DannyGH/Spectacle_Accelerometer_Input_Board/Hardware/Spectacle_Accelerometer_Input_Board.brd

## EAGLE design Hardware/Spectacle_Accelerometer_Input_Board.brd (2017-01-25)

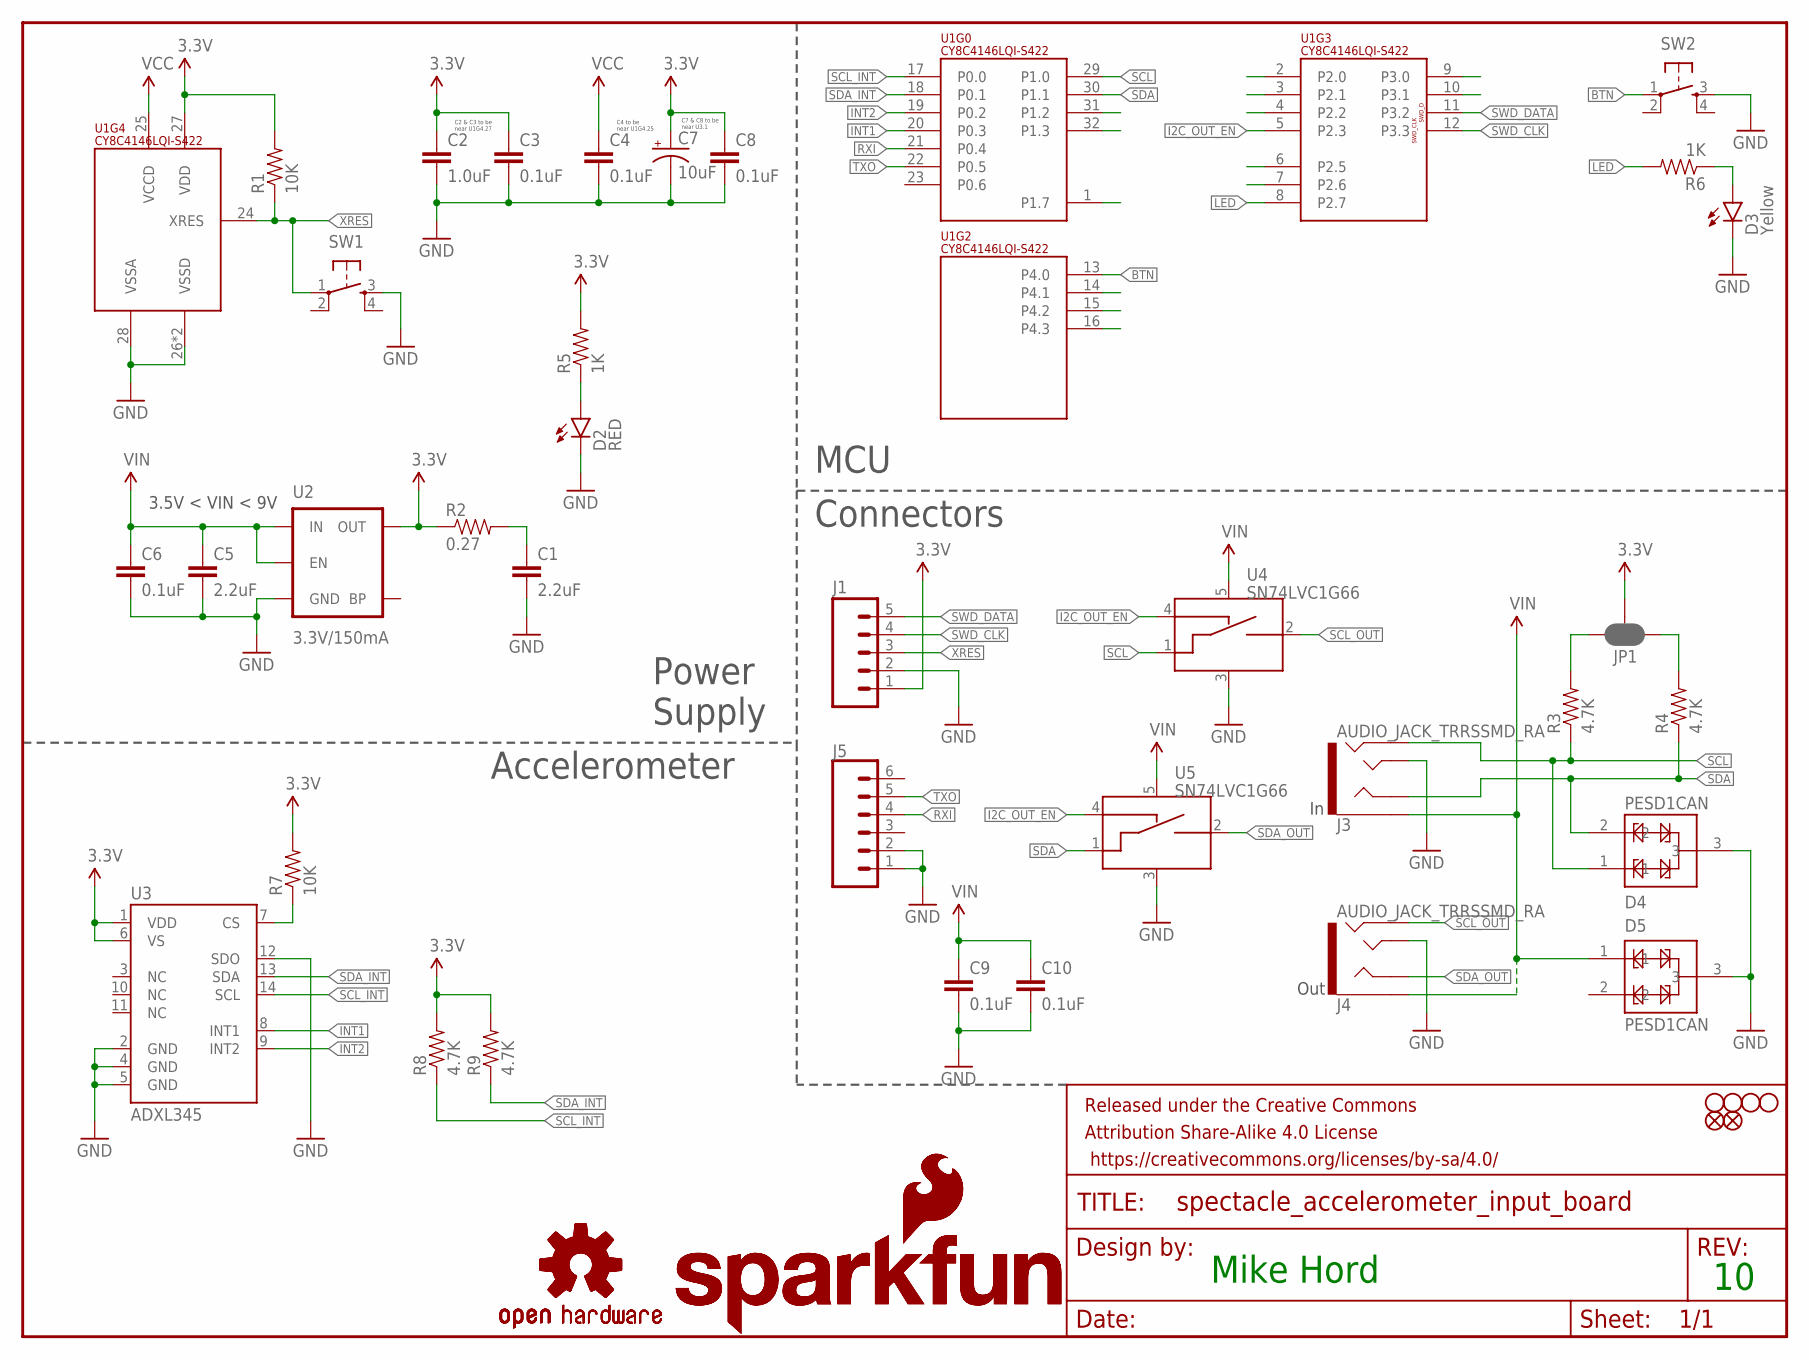
[picture p1: schematic Spectacle_Accelerometer_Input_Board.sch]

Parts:
C1, C5: 2.2uF; 0603-CAP
C2: 1.0uF; 0402-CAP
C3, C4, C6, C8, C9, C10: 0.1uF; 0402-CAP
C7: 10uF; EIA3216
D2: RED; LED-0603
D3: Yellow; LED-0603
D4, D5: PESD1CAN; SOT23-3
FD1, FD2: FIDUCIALUFIDUCIAL; MICRO-FIDUCIAL
FRAME1: FRAME-LETTER; CREATIVE_COMMONS
H1, H2, H3, H4: STAND-OFF
J1: M05NO_SILK; 1X05_NO_SILK
J3, J4: AUDIO_JACK_TRRSSMD_RA; AUDIO_JACK_3.5MM_TRRS_SMD_RA
J5: CONN_06NO_SILK_NO_POP; 1X06_NO_SILK
JP1: JUMPER-PAD-3-NC_BY_PASTE; PAD-JUMPER-3-NC_BY_PASTE_YES_SILK_FULL_BOX
LOGO1, LOGO4: SFE_LOGO_NAME_FLAME.1_INCH; SFE_LOGO_NAME_FLAME_.1
LOGO2, LOGO3: OSHW-LOGOS; OSHW-LOGO-S
R1, R7: 10K; 0603-RES
R2: 0.27; 0603-RES
R3, R4, R8, R9: 4.7K; 0603-RES
R5, R6: 1K; 0603-RES
SW1, SW2: SWITCH_SPST_4_PINRECT; TACTILE_SWITCH_SMD_4.6X2.8MM
U1: CY8C4146LQI-S422; QFN-32
U2: 3.3V/150mA; SOT23-5
U3: ADXL345; ADXL3451:1
U4, U5: SN74LVC1G66; SOT23-5

Connections:
3.3V: C2.1, C3.1, C7.A (+), C8.1, J1.1, JP1.2, R1.2, R2.1, R5.2, R7.2, R8.2, R9.2, U1.27 (VDD), U2.5 (OUT), U3.1 (VDD), U3.6 (VS)
BTN: SW2.1, U1.13 (P4.0)
GND: C1.2, C2.2, C3.2, C4.2, C5.2, C6.2, C7.C (-), C8.2, C9.2, C10.2, D2.C, D3.C, D4.3, D5.3, J1.2, J3.TIP, J4.TIP, J5.1, J5.2, SW1.3, SW2.3, U1.26 (VSSD), U1.28 (VSSA), U1.EP (VSSD), U2.2 (GND), U3.2 (GND), U3.4 (GND), U3.5 (GND), U3.12 (SDO), U4.3 (VSS), U5.3 (VSS)
I2C_OUT_EN: U1.5 (P2.3), U4.4 (CTRL_IN), U5.4 (CTRL_IN)
INT1: U1.20 (P0.3), U3.8 (INT1)
INT2: U1.19 (P0.2), U3.9 (INT2)
LED: R6.2, U1.8 (P2.7)
unnamed: JP1.3, R3.2
unnamed: C1.1, R2.2
unnamed: D2.A, R5.1
unnamed: D3.A, R6.1
unnamed: JP1.1, R4.2
unnamed: R7.1, U3.7 (CS)
RXI: J5.4, U1.21 (P0.4)
SCL: D4.1, J3.RING2, R3.1, U1.29 (P1.0), U4.1 (A_IN)
SCL_INT: R8.1, U1.17 (P0.0), U3.14 (SCL)
SCL_OUT: J4.RING2, U4.2 (A_OUT)
SDA: D4.2, J3.RING1, R4.1, U1.30 (P1.1), U5.1 (A_IN)
SDA_INT: R9.1, U1.18 (P0.1), U3.13 (SDA)
SDA_OUT: J4.RING1, U5.2 (A_OUT)
SWD_CLK: J1.4, U1.12 (P3.3)
SWD_DATA: J1.5, U1.11 (P3.2)
TXO: J5.5, U1.22 (P0.5)
VCC: C4.1, U1.25 (VCCD)
VIN: C5.1, C6.1, C9.1, C10.1, D5.1, J3.EARTH, J4.EARTH, U2.1 (IN), U2.3 (EN), U4.5 (VCC), U5.5 (VCC)
XRES: J1.3, R1.1, SW1.1, U1.24 (XRES)

Notes on the sheet:
C2 & C3 to be near U1G4.27
C4 to be near U1G4.25
C7 & C8 to be near U3.1
Mike Hord
Connectors
Accelerometer
MCU
Power Supply
3.5V < VIN < 9V
Out

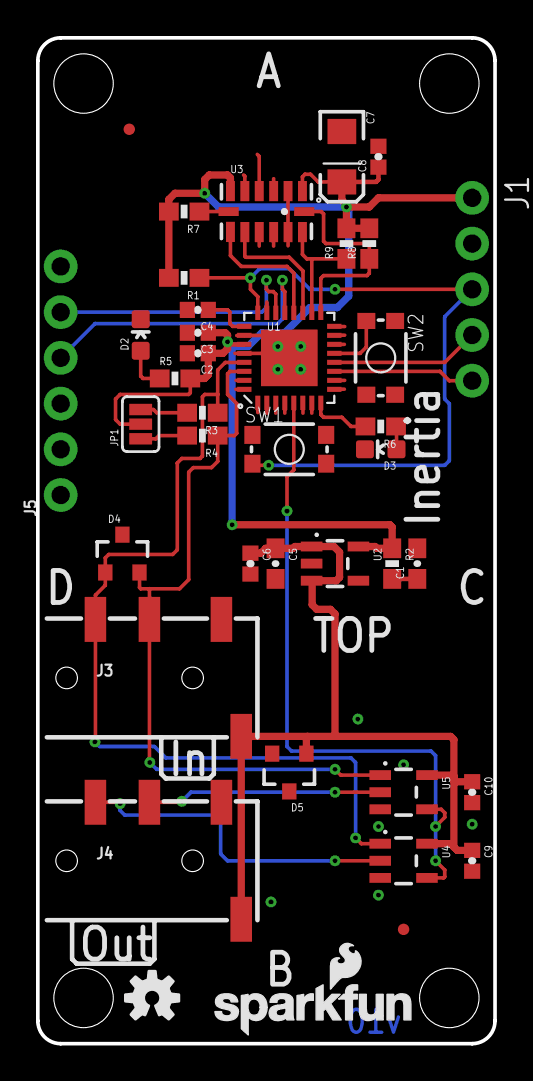
[picture p2: board Spectacle_Accelerometer_Input_Board.brd from above]

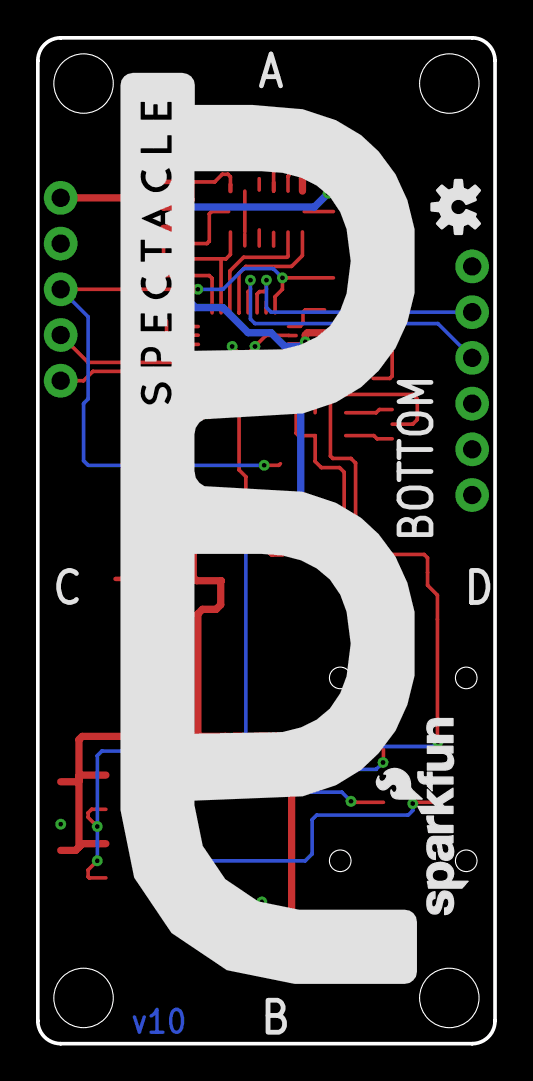
[picture p3: board Spectacle_Accelerometer_Input_Board.brd from below]

Board: 2 copper layers, 25.4 x 55.9 mm, 47 parts (3 on the bottom side), 26 nets.

Other parts of the board:
U$4: SPECTACLE_LOGO_NEGATIVE_2.2X1.0
