DannyGH/Spectacle_Accelerometer_Input_Board/Production/13464-Spectacle_Accelerometer_Input_Board-panel.v10.brd

## EAGLE design Production/13464-Spectacle_Accelerometer_Input_Board-panel.v10.brd (2017-02-10)

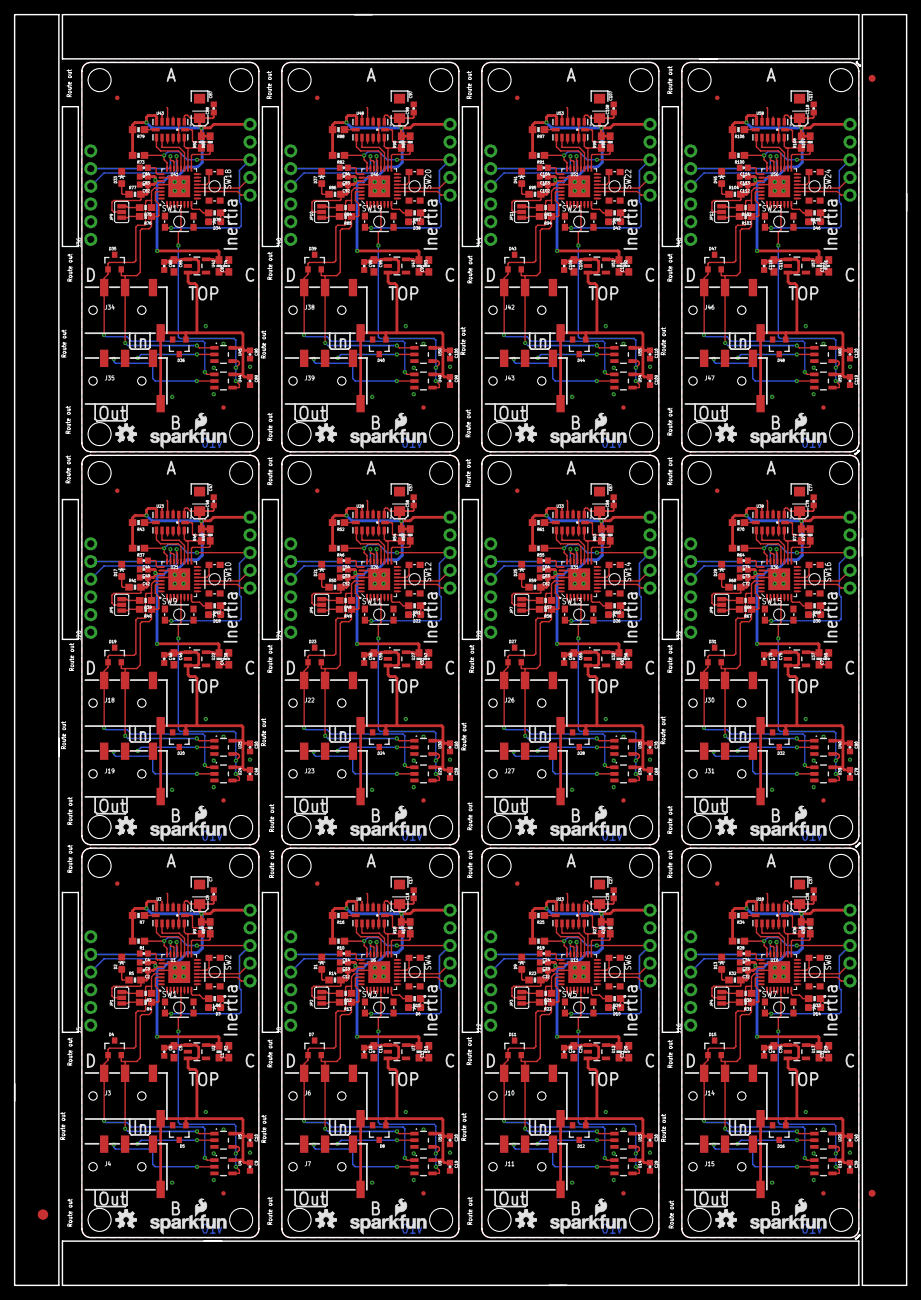
[picture p4: board 13464-Spectacle_Accelerometer_Input_Board-panel.v10.brd from above]

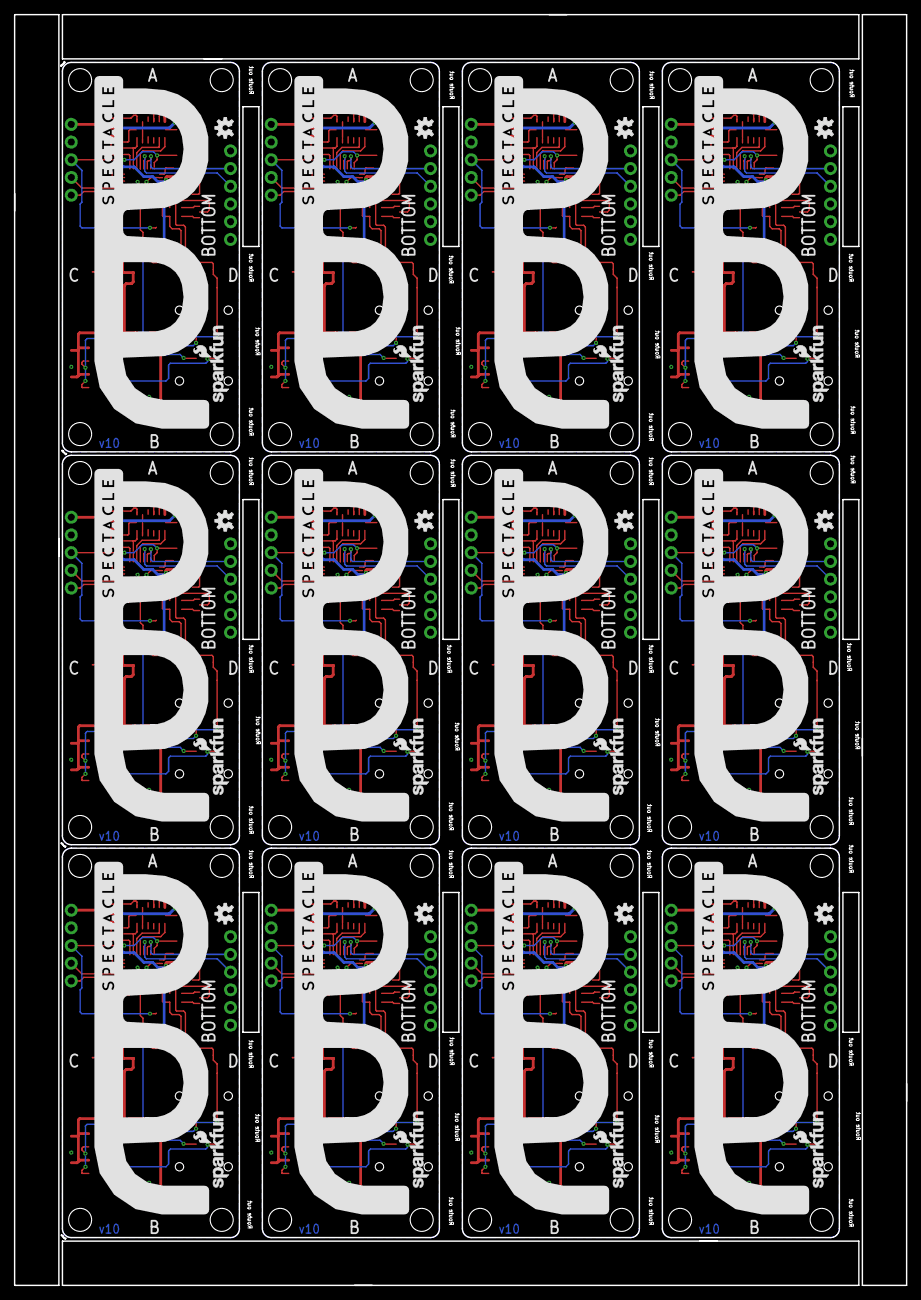
[picture p5: board 13464-Spectacle_Accelerometer_Input_Board-panel.v10.brd from below]

Board: 2 copper layers, 128.0 x 182.4 mm, 555 parts (36 on the bottom side), 312 nets.

Parts:
C1, C5, C11, C15, C21, C25, C31, C35, C41, C45, C51, C55, C61, C65, C71, C75, C81, C85, C91, C95, C101, C105, C111, C115: 2.2uF; 0603-CAP
C2, C12, C22, C32, C42, C52, C62, C72, C82, C92, C102, C112: 1.0uF; 0402-CAP
C3, C4, C6, C8, C9, C10, C13, C14, C16, C18, C19, C20, C23, C24, C26, C28, C29, C30, C33, C34, C36, C38, C39, C40, C43, C44, C46, C48, C49, C50, C53, C54, C56, C58, C59, C60, C63, C64, C66, C68, C69, C70, C73, C74, C76, C78, C79, C80, C83, C84, C86, C88, C89, C90, C93, C94, C96, C98, C99, C100, C103, C104, C106, C108, C109, C110, C113, C114, C116, C118, C119, C120: 0.1uF; 0402-CAP
C7, C17, C27, C37, C47, C57, C67, C77, C87, C97, C107, C117: 10uF; EIA3216
D1, D2, D9, D13, D17, D21, D25, D29, D33, D37, D41, D45: RED; LED-0603
D3, D6, D10, D14, D18, D22, D26, D30, D34, D38, D42, D46: Yellow; LED-0603
D4, D5, D7, D8, D11, D12, D15, D16, D19, D20, D23, D24, D27, D28, D31, D32, D35, D36, D39, D40, D43, D44, D47, D48: PESD1CAN; SOT23-3
E$1: FIDUCIAL-1.5X3
E$5, E$6: FIDUCIAL-1X2
FD1, FD2, FD3, FD4, FD5, FD6, FD7, FD8, FD9, FD10, FD11, FD12, FD13, FD14, FD15, FD16, FD17, FD18, FD19, FD20, FD21, FD22, FD23, FD24: FIDUCIALUFIDUCIAL; MICRO-FIDUCIAL
H1, H2, H3, H4, H5, H6, H7, H8, H9, H10, H11, H12, H13, H14, H15, H16, H17, H18, H19, H20, H21, H22, H23, H24, H25, H26, H27, H28, H29, H30, H31, H32, H33, H34, H35, H36, H37, H38, H39, H40, H41, H42, H43, H44, H45, H46, H47, H48: STAND-OFF
J1, J2, J9, J13, J17, J21, J25, J29, J33, J37, J41, J45: 1X05_NO_SILK
J3, J4, J6, J7, J10, J11, J14, J15, J18, J19, J22, J23, J26, J27, J30, J31, J34, J35, J38, J39, J42, J43, J46, J47: AUDIO_JACK_TRRSSMD_RA; AUDIO_JACK_3.5MM_TRRS_SMD_RA
J5, J8, J12, J16, J20, J24, J28, J32, J36, J40, J44, J48: 1X06_NO_SILK
JP1, JP2, JP3, JP4, JP5, JP6, JP7, JP8, JP9, JP10, JP11, JP12: JUMPER-PAD-3-NC_BY_PASTE; PAD-JUMPER-3-NC_BY_PASTE_YES_SILK_FULL_BOX
LOGO1, LOGO4, LOGO5, LOGO8, LOGO9, LOGO12, LOGO13, LOGO16, LOGO17, LOGO20, LOGO21, LOGO24, LOGO25, LOGO28, LOGO29, LOGO32, LOGO33, LOGO36, LOGO37, LOGO40, LOGO41, LOGO44, LOGO45, LOGO48: SFE_LOGO_NAME_FLAME.1_INCH; SFE_LOGO_NAME_FLAME_.1
LOGO2, LOGO3, LOGO6, LOGO7, LOGO10, LOGO11, LOGO14, LOGO15, LOGO18, LOGO19, LOGO22, LOGO23, LOGO26, LOGO27, LOGO30, LOGO31, LOGO34, LOGO35, LOGO38, LOGO39, LOGO42, LOGO43, LOGO46, LOGO47: OSHW-LOGOS; OSHW-LOGO-S
R1, R7, R10, R16, R19, R25, R28, R34, R37, R43, R46, R52, R55, R61, R64, R70, R73, R79, R82, R88, R91, R97, R100, R106: 10K; 0603-RES
R2, R11, R20, R29, R38, R47, R56, R65, R74, R83, R92, R101: 0.27; 0603-RES
R3, R4, R8, R9, R12, R13, R17, R18, R21, R22, R26, R27, R30, R31, R35, R36, R39, R40, R44, R45, R48, R49, R53, R54, R57, R58, R62, R63, R66, R67, R71, R72, R75, R76, R80, R81, R84, R85, R89, R90, R93, R94, R98, R99, R102, R103, R107, R108: 4.7K; 0603-RES
R5, R6, R14, R15, R23, R24, R32, R33, R41, R42, R50, R51, R59, R60, R68, R69, R77, R78, R86, R87, R95, R96, R104, R105: 1K; 0603-RES
SW1, SW2, SW3, SW4, SW5, SW6, SW7, SW8, SW9, SW10, SW11, SW12, SW13, SW14, SW15, SW16, SW17, SW18, SW19, SW20, SW21, SW22, SW23, SW24: TACTILE_SWITCH_SMD_4.6X2.8MM
U1, U6, U11, U16, U21, U26, U31, U36, U41, U46, U51, U56: CY8C4146LQI-S422; QFN-32
U2, U7, U12, U17, U22, U27, U32, U37, U42, U47, U52, U57: 3.3V/150mA; SOT23-5
U3, U8, U13, U18, U23, U28, U33, U38, U43, U48, U53, U58: ADXL345; ADXL3451:1
U4, U5, U9, U10, U14, U15, U19, U20, U24, U25, U29, U30, U34, U35, U39, U40, U44, U45, U49, U50, U54, U55, U59, U60: SN74LVC1G66; SOT23-5
U$1, U$2, U$3, U$4, U$5, U$6, U$7, U$8, U$9, U$10, U$11, U$12: SPECTACLE_LOGO_NEGATIVE_2.2X1.0

Connections:
3.3V: C2.1, C3.1, C7.A, C8.1, J1.1, JP1.2, R1.2, R2.1, R5.2, R7.2, R8.2, R9.2, U1.27, U2.5, U3.1, U3.6
3.3V1: C12.1, C13.1, C17.A, C18.1, J2.1, JP2.2, R10.2, R11.1, R14.2, R16.2, R17.2, R18.2, U6.27, U7.5, U8.1, U8.6
3.3V2: C22.1, C23.1, C27.A, C28.1, J9.1, JP3.2, R19.2, R20.1, R23.2, R25.2, R26.2, R27.2, U11.27, U12.5, U13.1, U13.6
3.3V3: C32.1, C33.1, C37.A, C38.1, J13.1, JP4.2, R28.2, R29.1, R32.2, R34.2, R35.2, R36.2, U16.27, U17.5, U18.1, U18.6
3.3V4: C42.1, C43.1, C47.A, C48.1, J17.1, JP5.2, R37.2, R38.1, R41.2, R43.2, R44.2, R45.2, U21.27, U22.5, U23.1, U23.6
3.3V5: C52.1, C53.1, C57.A, C58.1, J21.1, JP6.2, R46.2, R47.1, R50.2, R52.2, R53.2, R54.2, U26.27, U27.5, U28.1, U28.6
3.3V6: C62.1, C63.1, C67.A, C68.1, J25.1, JP7.2, R55.2, R56.1, R59.2, R61.2, R62.2, R63.2, U31.27, U32.5, U33.1, U33.6
3.3V7: C72.1, C73.1, C77.A, C78.1, J29.1, JP8.2, R64.2, R65.1, R68.2, R70.2, R71.2, R72.2, U36.27, U37.5, U38.1, U38.6
3.3V8: C82.1, C83.1, C87.A, C88.1, J33.1, JP9.2, R73.2, R74.1, R77.2, R79.2, R80.2, R81.2, U41.27, U42.5, U43.1, U43.6
3.3V9: C92.1, C93.1, C97.A, C98.1, J37.1, JP10.2, R82.2, R83.1, R86.2, R88.2, R89.2, R90.2, U46.27, U47.5, U48.1, U48.6
3.3V10: C102.1, C103.1, C107.A, C108.1, J41.1, JP11.2, R91.2, R92.1, R95.2, R97.2, R98.2, R99.2, U51.27, U52.5, U53.1, U53.6
3.3V11: C112.1, C113.1, C117.A, C118.1, J45.1, JP12.2, R100.2, R101.1, R104.2, R106.2, R107.2, R108.2, U56.27, U57.5, U58.1, U58.6
BTN: SW2.1, U1.13
BTN1: SW4.1, U6.13
BTN2: SW6.1, U11.13
BTN3: SW8.1, U16.13
BTN4: SW10.1, U21.13
BTN5: SW12.1, U26.13
BTN6: SW14.1, U31.13
BTN7: SW16.1, U36.13
BTN8: SW18.1, U41.13
BTN9: SW20.1, U46.13
BTN10: SW22.1, U51.13
BTN11: SW24.1, U56.13
GND: C1.2, C2.2, C3.2, C4.2, C5.2, C6.2, C7.C, C8.2, C9.2, C10.2, D2.C, D3.C, D4.3, D5.3, J1.2, J3.TIP, J4.TIP, J5.1, J5.2, SW1.3, SW2.3, U1.26, U1.28, U1.EP, U2.2, U3.2, U3.4, U3.5, U3.12, U4.3, U5.3
GND1: C11.2, C12.2, C13.2, C14.2, C15.2, C16.2, C17.C, C18.2, C19.2, C20.2, D1.C, D6.C, D7.3, D8.3, J2.2, J6.TIP, J7.TIP, J8.1, J8.2, SW3.3, SW4.3, U6.26, U6.28, U6.EP, U7.2, U8.2, U8.4, U8.5, U8.12, U9.3, U10.3
GND2: C21.2, C22.2, C23.2, C24.2, C25.2, C26.2, C27.C, C28.2, C29.2, C30.2, D9.C, D10.C, D11.3, D12.3, J9.2, J10.TIP, J11.TIP, J12.1, J12.2, SW5.3, SW6.3, U11.26, U11.28, U11.EP, U12.2, U13.2, U13.4, U13.5, U13.12, U14.3, U15.3
GND3: C31.2, C32.2, C33.2, C34.2, C35.2, C36.2, C37.C, C38.2, C39.2, C40.2, D13.C, D14.C, D15.3, D16.3, J13.2, J14.TIP, J15.TIP, J16.1, J16.2, SW7.3, SW8.3, U16.26, U16.28, U16.EP, U17.2, U18.2, U18.4, U18.5, U18.12, U19.3, U20.3
GND4: C41.2, C42.2, C43.2, C44.2, C45.2, C46.2, C47.C, C48.2, C49.2, C50.2, D17.C, D18.C, D19.3, D20.3, J17.2, J18.TIP, J19.TIP, J20.1, J20.2, SW9.3, SW10.3, U21.26, U21.28, U21.EP, U22.2, U23.2, U23.4, U23.5, U23.12, U24.3, U25.3
GND5: C51.2, C52.2, C53.2, C54.2, C55.2, C56.2, C57.C, C58.2, C59.2, C60.2, D21.C, D22.C, D23.3, D24.3, J21.2, J22.TIP, J23.TIP, J24.1, J24.2, SW11.3, SW12.3, U26.26, U26.28, U26.EP, U27.2, U28.2, U28.4, U28.5, U28.12, U29.3, U30.3
GND6: C61.2, C62.2, C63.2, C64.2, C65.2, C66.2, C67.C, C68.2, C69.2, C70.2, D25.C, D26.C, D27.3, D28.3, J25.2, J26.TIP, J27.TIP, J28.1, J28.2, SW13.3, SW14.3, U31.26, U31.28, U31.EP, U32.2, U33.2, U33.4, U33.5, U33.12, U34.3, U35.3
GND7: C71.2, C72.2, C73.2, C74.2, C75.2, C76.2, C77.C, C78.2, C79.2, C80.2, D29.C, D30.C, D31.3, D32.3, J29.2, J30.TIP, J31.TIP, J32.1, J32.2, SW15.3, SW16.3, U36.26, U36.28, U36.EP, U37.2, U38.2, U38.4, U38.5, U38.12, U39.3, U40.3
GND8: C81.2, C82.2, C83.2, C84.2, C85.2, C86.2, C87.C, C88.2, C89.2, C90.2, D33.C, D34.C, D35.3, D36.3, J33.2, J34.TIP, J35.TIP, J36.1, J36.2, SW17.3, SW18.3, U41.26, U41.28, U41.EP, U42.2, U43.2, U43.4, U43.5, U43.12, U44.3, U45.3
GND9: C91.2, C92.2, C93.2, C94.2, C95.2, C96.2, C97.C, C98.2, C99.2, C100.2, D37.C, D38.C, D39.3, D40.3, J37.2, J38.TIP, J39.TIP, J40.1, J40.2, SW19.3, SW20.3, U46.26, U46.28, U46.EP, U47.2, U48.2, U48.4, U48.5, U48.12, U49.3, U50.3
GND10: C101.2, C102.2, C103.2, C104.2, C105.2, C106.2, C107.C, C108.2, C109.2, C110.2, D41.C, D42.C, D43.3, D44.3, J41.2, J42.TIP, J43.TIP, J44.1, J44.2, SW21.3, SW22.3, U51.26, U51.28, U51.EP, U52.2, U53.2, U53.4, U53.5, U53.12, U54.3, U55.3
GND11: C111.2, C112.2, C113.2, C114.2, C115.2, C116.2, C117.C, C118.2, C119.2, C120.2, D45.C, D46.C, D47.3, D48.3, J45.2, J46.TIP, J47.TIP, J48.1, J48.2, SW23.3, SW24.3, U56.26, U56.28, U56.EP, U57.2, U58.2, U58.4, U58.5, U58.12, U59.3, U60.3
I2C_OUT_EN: U1.5, U4.4, U5.4
I2C_OUT_EN1: U6.5, U9.4, U10.4
I2C_OUT_EN2: U11.5, U14.4, U15.4
I2C_OUT_EN3: U16.5, U19.4, U20.4
I2C_OUT_EN4: U21.5, U24.4, U25.4
I2C_OUT_EN5: U26.5, U29.4, U30.4
I2C_OUT_EN6: U31.5, U34.4, U35.4
I2C_OUT_EN7: U36.5, U39.4, U40.4
I2C_OUT_EN8: U41.5, U44.4, U45.4
I2C_OUT_EN9: U46.5, U49.4, U50.4
I2C_OUT_EN10: U51.5, U54.4, U55.4
I2C_OUT_EN11: U56.5, U59.4, U60.4
INT1: U1.20, U3.8
INT2: U1.19, U3.9
INT3: U6.20, U8.8
INT4: U6.19, U8.9
INT5: U11.20, U13.8
INT6: U11.19, U13.9
INT7: U16.20, U18.8
INT8: U16.19, U18.9
INT9: U21.20, U23.8
INT10: U21.19, U23.9
INT11: U26.20, U28.8
INT12: U26.19, U28.9
INT13: U31.20, U33.8
INT14: U31.19, U33.9
INT15: U36.20, U38.8
INT16: U36.19, U38.9
INT17: U41.20, U43.8
INT18: U41.19, U43.9
INT19: U46.20, U48.8
INT20: U46.19, U48.9
INT21: U51.20, U53.8
INT22: U51.19, U53.9
INT23: U56.20, U58.8
INT24: U56.19, U58.9
LED: R6.2, U1.8
LED1: R15.2, U6.8
LED2: R24.2, U11.8
LED3: R33.2, U16.8
LED4: R42.2, U21.8
LED5: R51.2, U26.8
LED6: R60.2, U31.8
LED7: R69.2, U36.8
LED8: R78.2, U41.8
LED9: R87.2, U46.8
LED10: R96.2, U51.8
LED11: R105.2, U56.8
unnamed: JP1.3, R3.2
unnamed: C1.1, R2.2
unnamed: D2.A, R5.1
unnamed: D3.A, R6.1
unnamed: JP1.1, R4.2
unnamed: R7.1, U3.7
unnamed: C11.1, R11.2
unnamed: JP2.3, R12.2
unnamed: JP2.1, R13.2
unnamed: D1.A, R14.1
unnamed: D6.A, R15.1
unnamed: R16.1, U8.7
unnamed: C21.1, R20.2
unnamed: JP3.3, R21.2
unnamed: JP3.1, R22.2
unnamed: D9.A, R23.1
unnamed: D10.A, R24.1
unnamed: R25.1, U13.7
unnamed: C31.1, R29.2
unnamed: JP4.3, R30.2
unnamed: JP4.1, R31.2
unnamed: D13.A, R32.1
unnamed: D14.A, R33.1
unnamed: R34.1, U18.7
unnamed: C41.1, R38.2
unnamed: JP5.3, R39.2
unnamed: JP5.1, R40.2
unnamed: D17.A, R41.1
unnamed: D18.A, R42.1
unnamed: R43.1, U23.7
unnamed: C51.1, R47.2
unnamed: JP6.3, R48.2
unnamed: JP6.1, R49.2
unnamed: D21.A, R50.1
unnamed: D22.A, R51.1
unnamed: R52.1, U28.7
unnamed: C61.1, R56.2
unnamed: JP7.3, R57.2
unnamed: JP7.1, R58.2
unnamed: D25.A, R59.1
unnamed: D26.A, R60.1
unnamed: R61.1, U33.7
unnamed: C71.1, R65.2
unnamed: JP8.3, R66.2
unnamed: JP8.1, R67.2
unnamed: D29.A, R68.1
unnamed: D30.A, R69.1
unnamed: R70.1, U38.7
unnamed: C81.1, R74.2
unnamed: JP9.3, R75.2
unnamed: JP9.1, R76.2
unnamed: D33.A, R77.1
unnamed: D34.A, R78.1
unnamed: R79.1, U43.7
unnamed: C91.1, R83.2
unnamed: JP10.3, R84.2
unnamed: JP10.1, R85.2
unnamed: D37.A, R86.1
unnamed: D38.A, R87.1
unnamed: R88.1, U48.7
unnamed: C101.1, R92.2
unnamed: JP11.3, R93.2
unnamed: JP11.1, R94.2
unnamed: D41.A, R95.1
unnamed: D42.A, R96.1
unnamed: R97.1, U53.7
unnamed: C111.1, R101.2
unnamed: JP12.3, R102.2
unnamed: JP12.1, R103.2
unnamed: D45.A, R104.1
unnamed: D46.A, R105.1
unnamed: R106.1, U58.7
RXI: J5.4, U1.21
RXI1: J8.4, U6.21
RXI2: J12.4, U11.21
RXI3: J16.4, U16.21
RXI4: J20.4, U21.21
RXI5: J24.4, U26.21
RXI6: J28.4, U31.21
RXI7: J32.4, U36.21
RXI8: J36.4, U41.21
RXI9: J40.4, U46.21
RXI10: J44.4, U51.21
RXI11: J48.4, U56.21
SCL: D4.1, J3.RING2, R3.1, U1.29, U4.1
SCL1: D7.1, J6.RING2, R12.1, U6.29, U9.1
SCL2: D11.1, J10.RING2, R21.1, U11.29, U14.1
SCL3: D15.1, J14.RING2, R30.1, U16.29, U19.1
SCL4: D19.1, J18.RING2, R39.1, U21.29, U24.1
SCL5: D23.1, J22.RING2, R48.1, U26.29, U29.1
SCL6: D27.1, J26.RING2, R57.1, U31.29, U34.1
SCL7: D31.1, J30.RING2, R66.1, U36.29, U39.1
SCL8: D35.1, J34.RING2, R75.1, U41.29, U44.1
SCL9: D39.1, J38.RING2, R84.1, U46.29, U49.1
SCL10: D43.1, J42.RING2, R93.1, U51.29, U54.1
SCL11: D47.1, J46.RING2, R102.1, U56.29, U59.1
SCL_INT: R8.1, U1.17, U3.14
SCL_INT1: R17.1, U6.17, U8.14
SCL_INT2: R26.1, U11.17, U13.14
SCL_INT3: R35.1, U16.17, U18.14
SCL_INT4: R44.1, U21.17, U23.14
SCL_INT5: R53.1, U26.17, U28.14
SCL_INT6: R62.1, U31.17, U33.14
SCL_INT7: R71.1, U36.17, U38.14
SCL_INT8: R80.1, U41.17, U43.14
SCL_INT9: R89.1, U46.17, U48.14
SCL_INT10: R98.1, U51.17, U53.14
SCL_INT11: R107.1, U56.17, U58.14
SCL_OUT: J4.RING2, U4.2
SCL_OUT1: J7.RING2, U9.2
SCL_OUT2: J11.RING2, U14.2
SCL_OUT3: J15.RING2, U19.2
SCL_OUT4: J19.RING2, U24.2
SCL_OUT5: J23.RING2, U29.2
SCL_OUT6: J27.RING2, U34.2
SCL_OUT7: J31.RING2, U39.2
SCL_OUT8: J35.RING2, U44.2
SCL_OUT9: J39.RING2, U49.2
SCL_OUT10: J43.RING2, U54.2
SCL_OUT11: J47.RING2, U59.2
SDA: D4.2, J3.RING1, R4.1, U1.30, U5.1
SDA1: D7.2, J6.RING1, R13.1, U6.30, U10.1
SDA2: D11.2, J10.RING1, R22.1, U11.30, U15.1
SDA3: D15.2, J14.RING1, R31.1, U16.30, U20.1
SDA4: D19.2, J18.RING1, R40.1, U21.30, U25.1
SDA5: D23.2, J22.RING1, R49.1, U26.30, U30.1
SDA6: D27.2, J26.RING1, R58.1, U31.30, U35.1
SDA7: D31.2, J30.RING1, R67.1, U36.30, U40.1
SDA8: D35.2, J34.RING1, R76.1, U41.30, U45.1
SDA9: D39.2, J38.RING1, R85.1, U46.30, U50.1
SDA10: D43.2, J42.RING1, R94.1, U51.30, U55.1
SDA11: D47.2, J46.RING1, R103.1, U56.30, U60.1
SDA_INT: R9.1, U1.18, U3.13
SDA_INT1: R18.1, U6.18, U8.13
SDA_INT2: R27.1, U11.18, U13.13
SDA_INT3: R36.1, U16.18, U18.13
SDA_INT4: R45.1, U21.18, U23.13
SDA_INT5: R54.1, U26.18, U28.13
SDA_INT6: R63.1, U31.18, U33.13
SDA_INT7: R72.1, U36.18, U38.13
SDA_INT8: R81.1, U41.18, U43.13
SDA_INT9: R90.1, U46.18, U48.13
SDA_INT10: R99.1, U51.18, U53.13
SDA_INT11: R108.1, U56.18, U58.13
SDA_OUT: J4.RING1, U5.2
SDA_OUT1: J7.RING1, U10.2
SDA_OUT2: J11.RING1, U15.2
SDA_OUT3: J15.RING1, U20.2
SDA_OUT4: J19.RING1, U25.2
SDA_OUT5: J23.RING1, U30.2
SDA_OUT6: J27.RING1, U35.2
SDA_OUT7: J31.RING1, U40.2
SDA_OUT8: J35.RING1, U45.2
SDA_OUT9: J39.RING1, U50.2
SDA_OUT10: J43.RING1, U55.2
SDA_OUT11: J47.RING1, U60.2
SWD_CLK: J1.4, U1.12
SWD_CLK1: J2.4, U6.12
SWD_CLK2: J9.4, U11.12
SWD_CLK3: J13.4, U16.12
SWD_CLK4: J17.4, U21.12
SWD_CLK5: J21.4, U26.12
SWD_CLK6: J25.4, U31.12
SWD_CLK7: J29.4, U36.12
SWD_CLK8: J33.4, U41.12
SWD_CLK9: J37.4, U46.12
SWD_CLK10: J41.4, U51.12
SWD_CLK11: J45.4, U56.12
SWD_DATA: J1.5, U1.11
SWD_DATA1: J2.5, U6.11
SWD_DATA2: J9.5, U11.11
SWD_DATA3: J13.5, U16.11
SWD_DATA4: J17.5, U21.11
SWD_DATA5: J21.5, U26.11
SWD_DATA6: J25.5, U31.11
SWD_DATA7: J29.5, U36.11
SWD_DATA8: J33.5, U41.11
SWD_DATA9: J37.5, U46.11
SWD_DATA10: J41.5, U51.11
SWD_DATA11: J45.5, U56.11
TXO: J5.5, U1.22
TXO1: J8.5, U6.22
TXO2: J12.5, U11.22
TXO3: J16.5, U16.22
TXO4: J20.5, U21.22
TXO5: J24.5, U26.22
TXO6: J28.5, U31.22
TXO7: J32.5, U36.22
TXO8: J36.5, U41.22
TXO9: J40.5, U46.22
TXO10: J44.5, U51.22
TXO11: J48.5, U56.22
VCC: C4.1, U1.25
VCC1: C14.1, U6.25
VCC2: C24.1, U11.25
VCC3: C34.1, U16.25
VCC4: C44.1, U21.25
VCC5: C54.1, U26.25
VCC6: C64.1, U31.25
VCC7: C74.1, U36.25
VCC8: C84.1, U41.25
VCC9: C94.1, U46.25
VCC10: C104.1, U51.25
VCC11: C114.1, U56.25
VIN: C5.1, C6.1, C9.1, C10.1, D5.1, J3.EARTH, J4.EARTH, U2.1, U2.3, U4.5, U5.5
VIN1: C15.1, C16.1, C19.1, C20.1, D8.1, J6.EARTH, J7.EARTH, U7.1, U7.3, U9.5, U10.5
VIN2: C25.1, C26.1, C29.1, C30.1, D12.1, J10.EARTH, J11.EARTH, U12.1, U12.3, U14.5, U15.5
VIN3: C35.1, C36.1, C39.1, C40.1, D16.1, J14.EARTH, J15.EARTH, U17.1, U17.3, U19.5, U20.5
VIN4: C45.1, C46.1, C49.1, C50.1, D20.1, J18.EARTH, J19.EARTH, U22.1, U22.3, U24.5, U25.5
VIN5: C55.1, C56.1, C59.1, C60.1, D24.1, J22.EARTH, J23.EARTH, U27.1, U27.3, U29.5, U30.5
VIN6: C65.1, C66.1, C69.1, C70.1, D28.1, J26.EARTH, J27.EARTH, U32.1, U32.3, U34.5, U35.5
VIN7: C75.1, C76.1, C79.1, C80.1, D32.1, J30.EARTH, J31.EARTH, U37.1, U37.3, U39.5, U40.5
VIN8: C85.1, C86.1, C89.1, C90.1, D36.1, J34.EARTH, J35.EARTH, U42.1, U42.3, U44.5, U45.5
VIN9: C95.1, C96.1, C99.1, C100.1, D40.1, J38.EARTH, J39.EARTH, U47.1, U47.3, U49.5, U50.5
VIN10: C105.1, C106.1, C109.1, C110.1, D44.1, J42.EARTH, J43.EARTH, U52.1, U52.3, U54.5, U55.5
VIN11: C115.1, C116.1, C119.1, C120.1, D48.1, J46.EARTH, J47.EARTH, U57.1, U57.3, U59.5, U60.5
XRES: J1.3, R1.1, SW1.1, U1.24
XRES1: J2.3, R10.1, SW3.1, U6.24
XRES2: J9.3, R19.1, SW5.1, U11.24
XRES3: J13.3, R28.1, SW7.1, U16.24
XRES4: J17.3, R37.1, SW9.1, U21.24
XRES5: J21.3, R46.1, SW11.1, U26.24
XRES6: J25.3, R55.1, SW13.1, U31.24
XRES7: J29.3, R64.1, SW15.1, U36.24
XRES8: J33.3, R73.1, SW17.1, U41.24
XRES9: J37.3, R82.1, SW19.1, U46.24
XRES10: J41.3, R91.1, SW21.1, U51.24
XRES11: J45.3, R100.1, SW23.1, U56.24
