DannyGH/Spectacle_Accelerometer_Input_Board/Firmware/Spectacle_Accelerometer_Input_Board/Spectacle_Accelerometer_Input_Board.cydsn/xl.h

/****************************************************************************
xl.h
Defines for general accelerometer
Mike Hord @ SparkFun Electronics
24 Jan 2017
https://github.com/sparkfun/Spectacle_Accelerometer_Input_Board

This file contains general purpose definitions for any I2C accelerometer. If
the accelerometer must be changed in the future, this file need not change.

Development environment specifics:
Developed in PSoC Creator 4.0

This code is beerware; if you see me (or any other SparkFun employee) at the
local, and you've found our code helpful, please buy us a round!
****************************************************************************/
    
#ifndef __servo_h_
#define __servo_h_
#include <project.h>  
#include <stdbool.h>

#define USER_DATA_LEN 3
    
#pragma pack(1)
struct xl
{
  uint8 channel;
  uint8 mode;
  uint8 momentary;
    // End of user configurable data
  uint8 orientation;
  uint8 active;
  uint8 inactive;
  int16 X;
  int16 Y;
  int16 Z;
  int32 xlTimer;
};
#pragma pack()

bool read16Bits(uint8 address, int16 *read);
bool read8Bits(uint8 address, uint8 *read);
bool write8Bits(uint8 address, uint8 write);
uint8 findMaxAxis(int16 x, int16 y, int16 z);
struct xl xlInit(uint8 channel, uint8 mode, uint8 momentary);

enum {ACTIVE, INACTIVE, SIDE_A_UP, SIDE_B_UP, SIDE_C_UP, SIDE_D_UP,
      SIDE_TOP_UP, SIDE_BOTTOM_UP, WRITE_X, WRITE_Y, WRITE_Z};

#endif
  
