DannyGH/Spectacle_Accelerometer_Input_Board/(commit log)

2016-07-15 Derived from button board
    [Spectacle_Button_Board.brd, Spectacle_Button_Board.sch]
2016-07-15 Initial commit of new design files
    [Spectacle_Accelerometer_Input_Board.brd, Spectacle_Accelerometer_Input_Board.sch]
2016-07-18 Cleared some DRC errors
    [Spectacle_Accelerometer_Input_Board.brd]
2016-07-21 Review feedback
    [Spectacle_Accelerometer_Input_Board.brd, Spectacle_Accelerometer_Input_Board.sch]
2016-07-26 Fixed issues from Eric's review
    [Spectacle_Accelerometer_Input_Board.brd, Spectacle_Accelerometer_Input_Board.sch]
2016-10-11 Added downstream power control circuitry
    [Spectacle_Accelerometer_Input_Board.brd, Spectacle_Accelerometer_Input_Board.sch]
2016-10-12 Nice place for a code commit. Has structure of I2C registers in place, along with necessary handlers and updates for new styles.
2016-10-13 Added notes to IN and OUT connectors
    [Spectacle_Accelerometer_Input_Board.brd, Spectacle_Accelerometer_Input_Board.sch]
2016-10-20 Fixes from design review
    [Spectacle_Accelerometer_Input_Board.brd, Spectacle_Accelerometer_Input_Board.sch]
2016-10-20 Some changes during checklist
    [Spectacle_Accelerometer_Input_Board.brd]
2016-10-24 Fixed missing tCream on pad 19 of psoc IC
    [Spectacle_Accelerometer_Input_Board.brd, Spectacle_Accelerometer_Input_Board.sch]
2016-10-28 I2C disconnect circuitry added
    [Spectacle_Accelerometer_Input_Board.brd, Spectacle_Accelerometer_Input_Board.sch]
2016-10-31 Change 2.2k I2C pullup to 4.7k Add Arduino test sketch
    [Spectacle_Accelerometer_Input_Board.brd, Spectacle_Accelerometer_Input_Board.sch]
2017-01-23 Touch-ups for v10 release
    [Spectacle_Accelerometer_Input_Board.brd, Spectacle_Accelerometer_Input_Board.sch]
2017-01-25 Update silk to reflect name Inertia
    [Spectacle_Accelerometer_Input_Board.brd]
2017-04-05 Change UART speed to 9600
